mdion1/PCBA_power_supply/power supply enclosure rev 2/front panel cover countersunk holes.pptx

ø3.6mm holes must be countersunk to a depth of 1.2mm and a diameter of 5.7mm

Front view

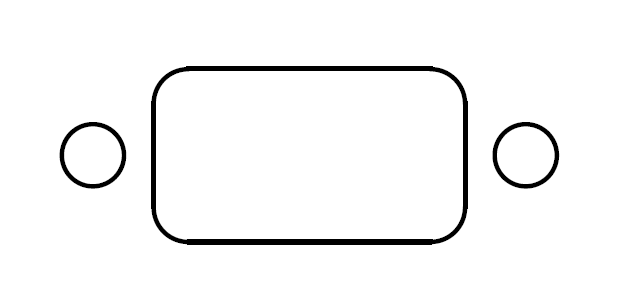
[picture p1: figure]

(Overall thickness measured to be ~2.8mm)

(Panel exterior face)

Side view of individual hole

1.2mm

ø5.7mm

ø3.6mm

(Panel interior face)
