mdion1/PCBA_power_supply/Rev1/Power supply BOM 2017_04_25.xlsx

Part ID | Qty | Notes | Value | Footprint | Vendor | Vendor PN
C1, 2, 3, 4 | 4 |  | 2200u, 35V | Thru-hole | Mouser | 667-EEU-FR1V222B | 4
C5 | 1 |  | 2.2u, 35V | SMT 0805 | Mouser | 81-GRM219C8YA225KE5D | 1
C6 | 1 |  | 22u, 10V | SMT 0805 | Mouser | 810-C2012JB1V226M12C | 1
C7, 9, 11, 13 | 4 |  | 10u, 35V | SMT 0805 | Mouser | 81-GRM21BR6YA106KE3L | 963-GMK212BBJ106KG-T alt
C8, 10, 12, 14 | 4 |  | 100n, 35V | SMT 0603 | Mouser | 963-GMK107BJ104KAHT | 4
J1 | 1 |  |  | Thru-hole | Mouser | 562-703W-00/54 | 1
J2 | 1 |  |  | Thru-hole | Mouser | 649-D09S33E4PA00LF | 1, missing "1" in name, also has another correct entry
L1, 2, 3, 4 | 4 |  |  | Thru-hole | Mouser | 983-T60006-L2016W403 | 4
R1 | 1 |  | 42.2k | SMT 0603 | Mouser | 71-TNPW060342K2BEEA | 1
R2 | 1 |  | 154k | SMT 0603 | Mouser | 667-ERA-3AEB1543V | 1
U1, 2 | 2 |  |  | Thru-hole | Mouser | 709-IRM30-24 | 2, backordered mouser
U3 | 1 |  |  | LGA-50 | Digikey | LTM8022EV#PBF-ND | 1
 |  |  |  |  |  | 963-GMK212BBJ106KG-T (http://www.mouser.com/Search/ProductDetail.aspx) | 4
 |  |  |  |  |  | IRM-30-24 from allied, backordered
