mdion1/PCBA_power_supply/Rev5 Kicad/BOM pwr supply rev 5 2019_09_04 abridged.xlsx

Designator | Mfr P/N
PS2,PS1 | TPP 30-115A-D
C1 | C1608JB1E225M080AB
C2,C3,C6,C7,C10,C11,C15,C16 | GMK107BJ105KAHT
C4,C5,C8,C9,C12,C13,C17,C18 | EEU-FR1V561
C14 | EMK212BBJ226MG-T
J2 | ID09S33E4GX00LF
R1 | ERA-3AEB4222V
R2 | ERA3AEB1543V
J1 | 703W-00/54
C19,C20,C21,C22,C23,C24,C25,C26 | 885012206089
U1 | LTM8022EV#PBF
L1,L2,L3,L4,L5,L6,L7,L8 | ASPI-6045S-100M-T
D1,D2 | TP1.5KE18A
