mdion1/PCBA_power_supply/Rev5 Kicad/BOM pwr supply rev 5 2019_09_04.xlsx

Designator | Package | Quantity | Designation | Supplier | Supplier P/N | Alternatives
PS2,PS1 | TPP 30-115A-D | 2 | TPP 30-115A-D | Mouser | 495-TPP30-115A-D |  | $35.63/e @ qty 25
C1 | C_0603 | 1 | 2.2u | Mouser | C1608JB1E225M080AB | C1608X5R1E225K080AE | $0.113/e @ qty 10
C2,C3,C6,C7,C10,C11,C15,C16 | C_0603 | 8 | 1u | Mouser | 963-GMK107BJ105KAHT | CL10A105KB8NNNC, GRT188R61H105ME13D | $0.104/e @ qty 100
C4,C5,C8,C9,C12,C13,C17,C18 | CP_Radial_D10.0mm_P5.00mm | 8 | 560u | Mouser | 667-EEU-FR1V561 | EEU-FS1V102LB ? | $0.373/e @ qty 100
C14 | C_0805 | 1 | 22u | Mouser | EMK212BBJ226MG-T | GRM219R61C226ME15K | $0.442/e @ qty 10
J2 | DB9FC | 1 | DB9_Female_MountingHoles | Mouser | 649-ID09S33E4GX00LF |  | $0.827/e @ qty 10
R1 | R_0603 | 1 | 42.2k | Mouser | ERA-3AEB4222V |  | $0.249/e @ qty 10
R2 | R_0603 | 1 | 154k | Mouser | 667-ERA-3AEB1543V |  | $0.249/e @ qty 10
J1 | AC_receptacle | 1 | Conn_WallPlug_Earth | Mouser | 562-703W-00/54 |  | $0.858/e @ qty 20
C19,C20,C21,C22,C23,C24,C25,C26 | C_0603 | 8 | 10n | Mouser | 710-885012206089 | GCM188R72A103KA37D | $0.054/e @ qty 100
U1 | LGA-50 | 1 | LTM8022 | Digikey | LTM8022EV#PBF-ND |  | $10.13/e @ qty 25
L1,L2,L3,L4,L5,L6,L7,L8 | 6045_inductor | 8 | 10u | Mouser | 815-ASPI-6045S-100MT |  | $0.468/e @ qty 50
D1,D2 | Thru-hole, vertical | 2 | 18v | Mouser | 576-TP1.5KE18A |  | $0.62/e @ qty 10
 |  | 43
