mdion1/PCBA_power_supply/power supply enclosure/lid.stl

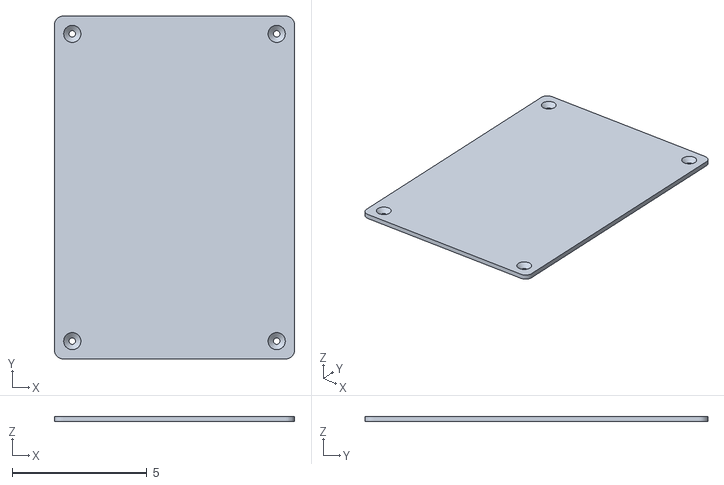
[picture p2: CAD file, 2021-01-22]
power supply enclosure/lid.stl
8.89 x 12.7 x 0.201
