mdion1/PCBA_power_supply/power supply enclosure/Bud enclosure CU389.stp

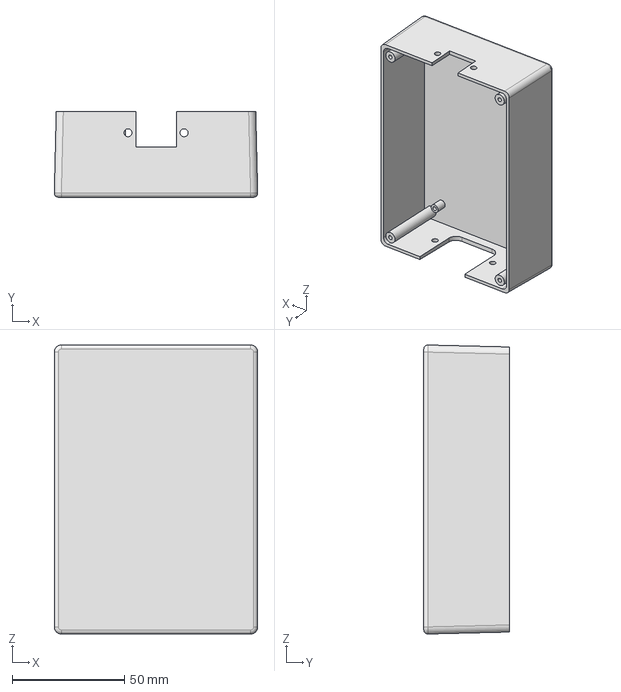
[picture p3: CAD file, 2021-01-22]
power supply enclosure/Bud enclosure CU389.stp
90.6 x 38.1 x 128.7 mm
