mdion1/PCBA_power_supply/(list of files, cad)

Other CAD files:
old revisions/power supply enclosure/AC entry module.ipt
old revisions/power supply enclosure/Assembly1.iam
old revisions/power supply enclosure/Bud enclosure CU389.idw
old revisions/power supply enclosure/Bud enclosure CU389.ipt
old revisions/power supply enclosure/Bud enclosure CU389.stl
old revisions/power supply enclosure/OldVersions/Assembly1.0006.iam
old revisions/power supply enclosure/OldVersions/Bud enclosure CU389.0004.idw
old revisions/power supply enclosure/OldVersions/Bud enclosure CU389.0008.ipt
old revisions/power supply enclosure/OldVersions/power supply pcb.0004.ipt
old revisions/power supply enclosure/lid.ipt
old revisions/power supply enclosure/power supply pcb.ipt
power supply enclosure rev 2/AC entry module.ipt
power supply enclosure rev 2/AC entry module.newVer.ipt
power supply enclosure rev 2/Assembly 2017_08_31.iam
power supply enclosure rev 2/DB9 connector 2017_06_14.ipt
power supply enclosure rev 2/Enclosure front and back faces.idw
power supply enclosure rev 2/OldVersions/Assembly 2017_06_14.0002.iam
power supply enclosure rev 2/OldVersions/Assembly 2017_08_23.0006.iam
power supply enclosure rev 2/OldVersions/Assembly 2017_08_31.0006.iam
power supply enclosure rev 2/OldVersions/Assembly1.0011.iam
power supply enclosure rev 2/OldVersions/Bigger slide switch 2017_06_14.0001.ipt
power supply enclosure rev 2/OldVersions/DB15 connector 2017_06_14.0001.ipt
power supply enclosure rev 2/OldVersions/DB15 connector.0001.ipt
power supply enclosure rev 2/OldVersions/DB9 connector 2017_06_14.0004.ipt
power supply enclosure rev 2/OldVersions/DB9 connector.0001.ipt
power supply enclosure rev 2/OldVersions/DB9 connector.0002.ipt
power supply enclosure rev 2/OldVersions/Enclosure front and back faces.0023.idw
power supply enclosure rev 2/OldVersions/Grounded banana jack.0001.ipt
power supply enclosure rev 2/OldVersions/PCB.0002.ipt
power supply enclosure rev 2/OldVersions/Slide switch.0002.ipt
power supply enclosure rev 2/OldVersions/USB A block.0003.ipt
power supply enclosure rev 2/OldVersions/back cover.0016.ipt
power supply enclosure rev 2/OldVersions/front cover.0019.ipt
power supply enclosure rev 2/On-off pushbutton.ipt
power supply enclosure rev 2/PCB.ipt
power supply enclosure rev 2/back cover.ipt
power supply enclosure rev 2/front cover.ipt
power supply enclosure/AC entry module.ipt
power supply enclosure/Assembly1.iam
power supply enclosure/Bud enclosure CU389.idw
power supply enclosure/Bud enclosure CU389.ipt
power supply enclosure/Bud enclosure CU389.stl
power supply enclosure/lid.ipt
power supply enclosure/power supply pcb.ipt
