mdion1/PCBA_power_supply/power supply enclosure rev 2/Power supply enclosure front and back faces 2017_9_29.pdf

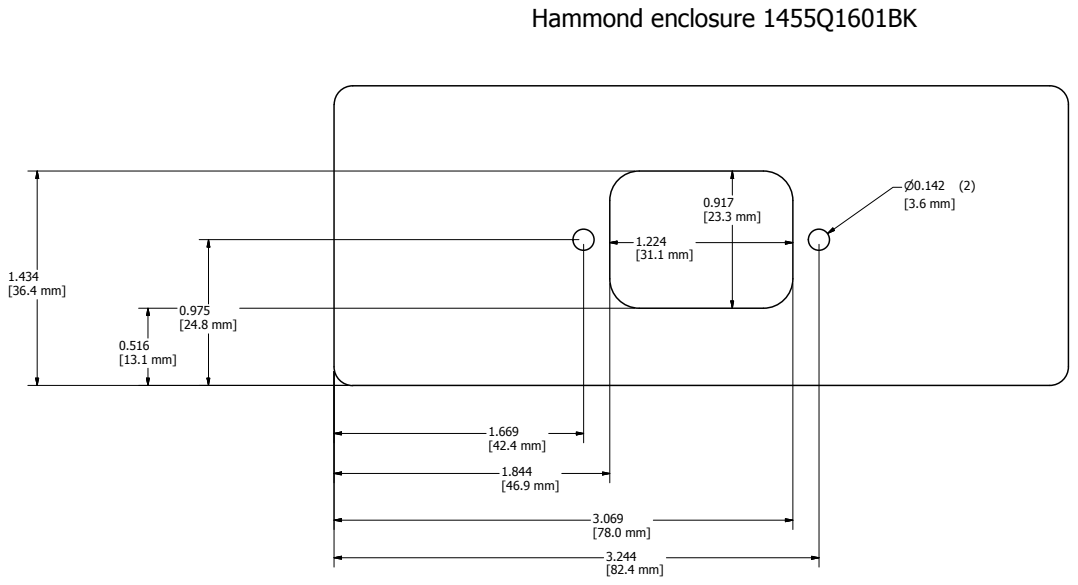
[picture p8: page 1]
SHEET 1 OF 2; DRAWN; CHECKED; MFG; APPROVED; Brandon; TITLE; SIZE C; SCALE; REV; Hammond enclosure 1455Q1601BK

DWG NO
Enclosure front and back faces

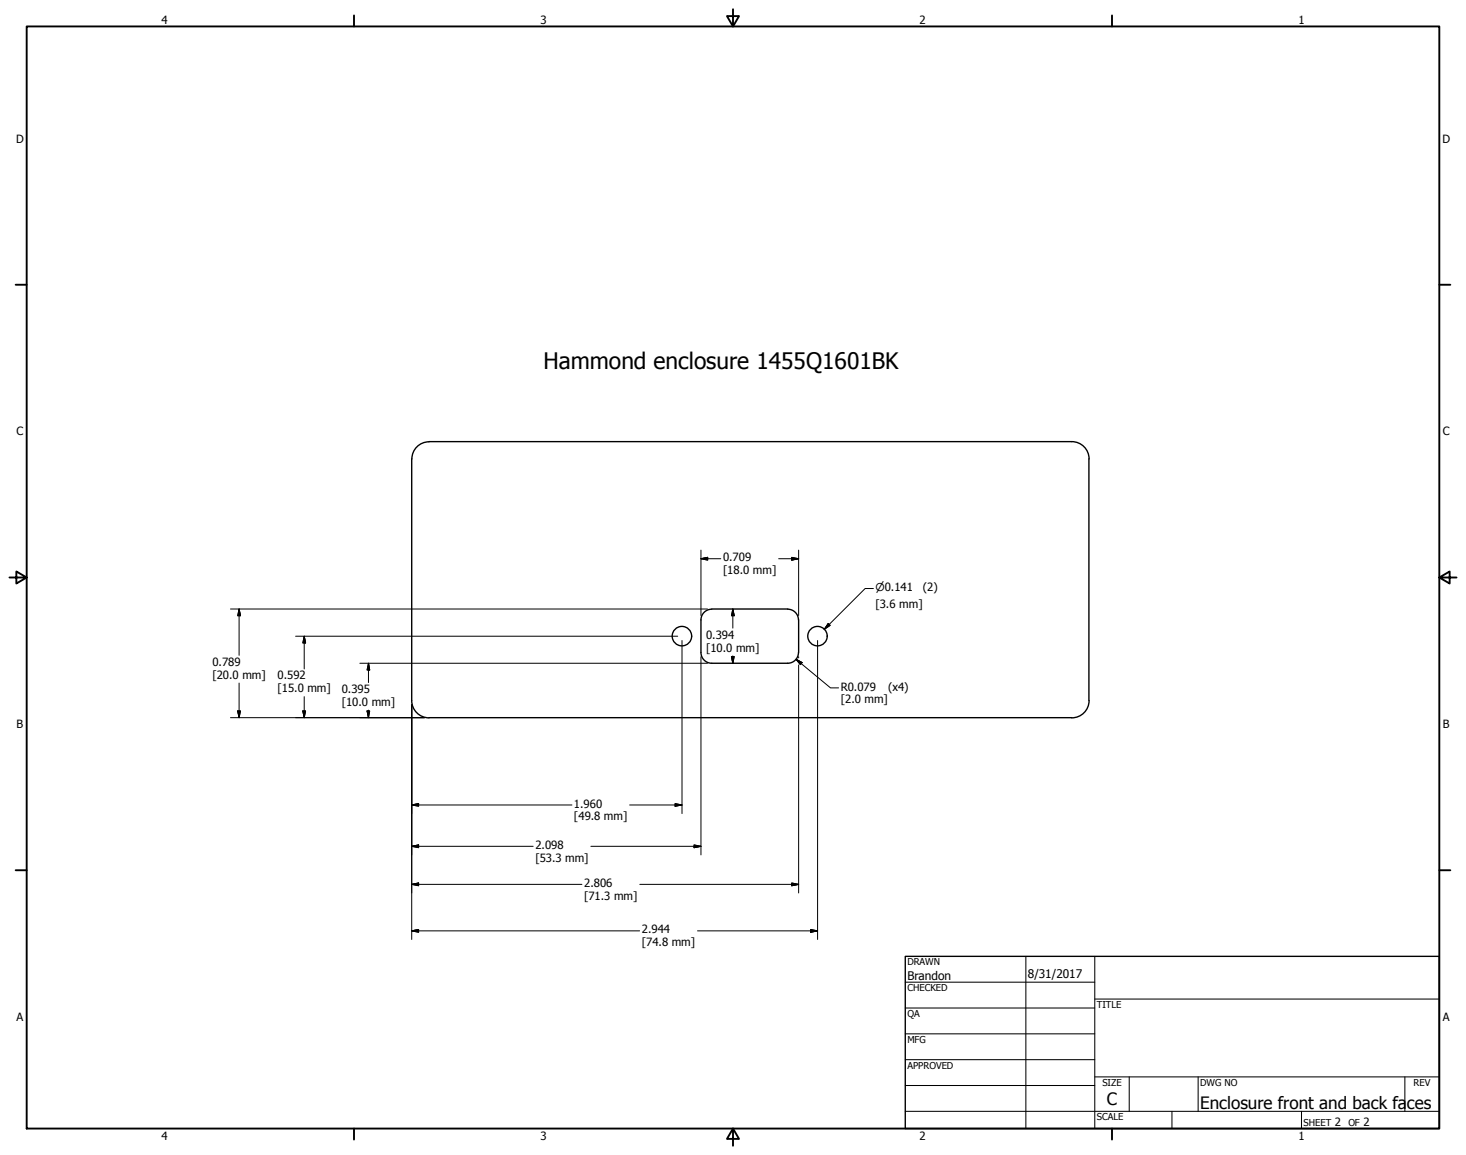
[picture p9: page 2]
SHEET 2 OF 2; DRAWN; CHECKED; MFG; APPROVED; Brandon; TITLE; SIZE C; SCALE; REV; Hammond enclosure 1455Q1601BK

DWG NO
Enclosure front and back faces
