mdion1/PCBA_power_supply/power supply enclosure/Bud enclosure CU389.pdf

# Bud plastic enclosure CU-389

# Front

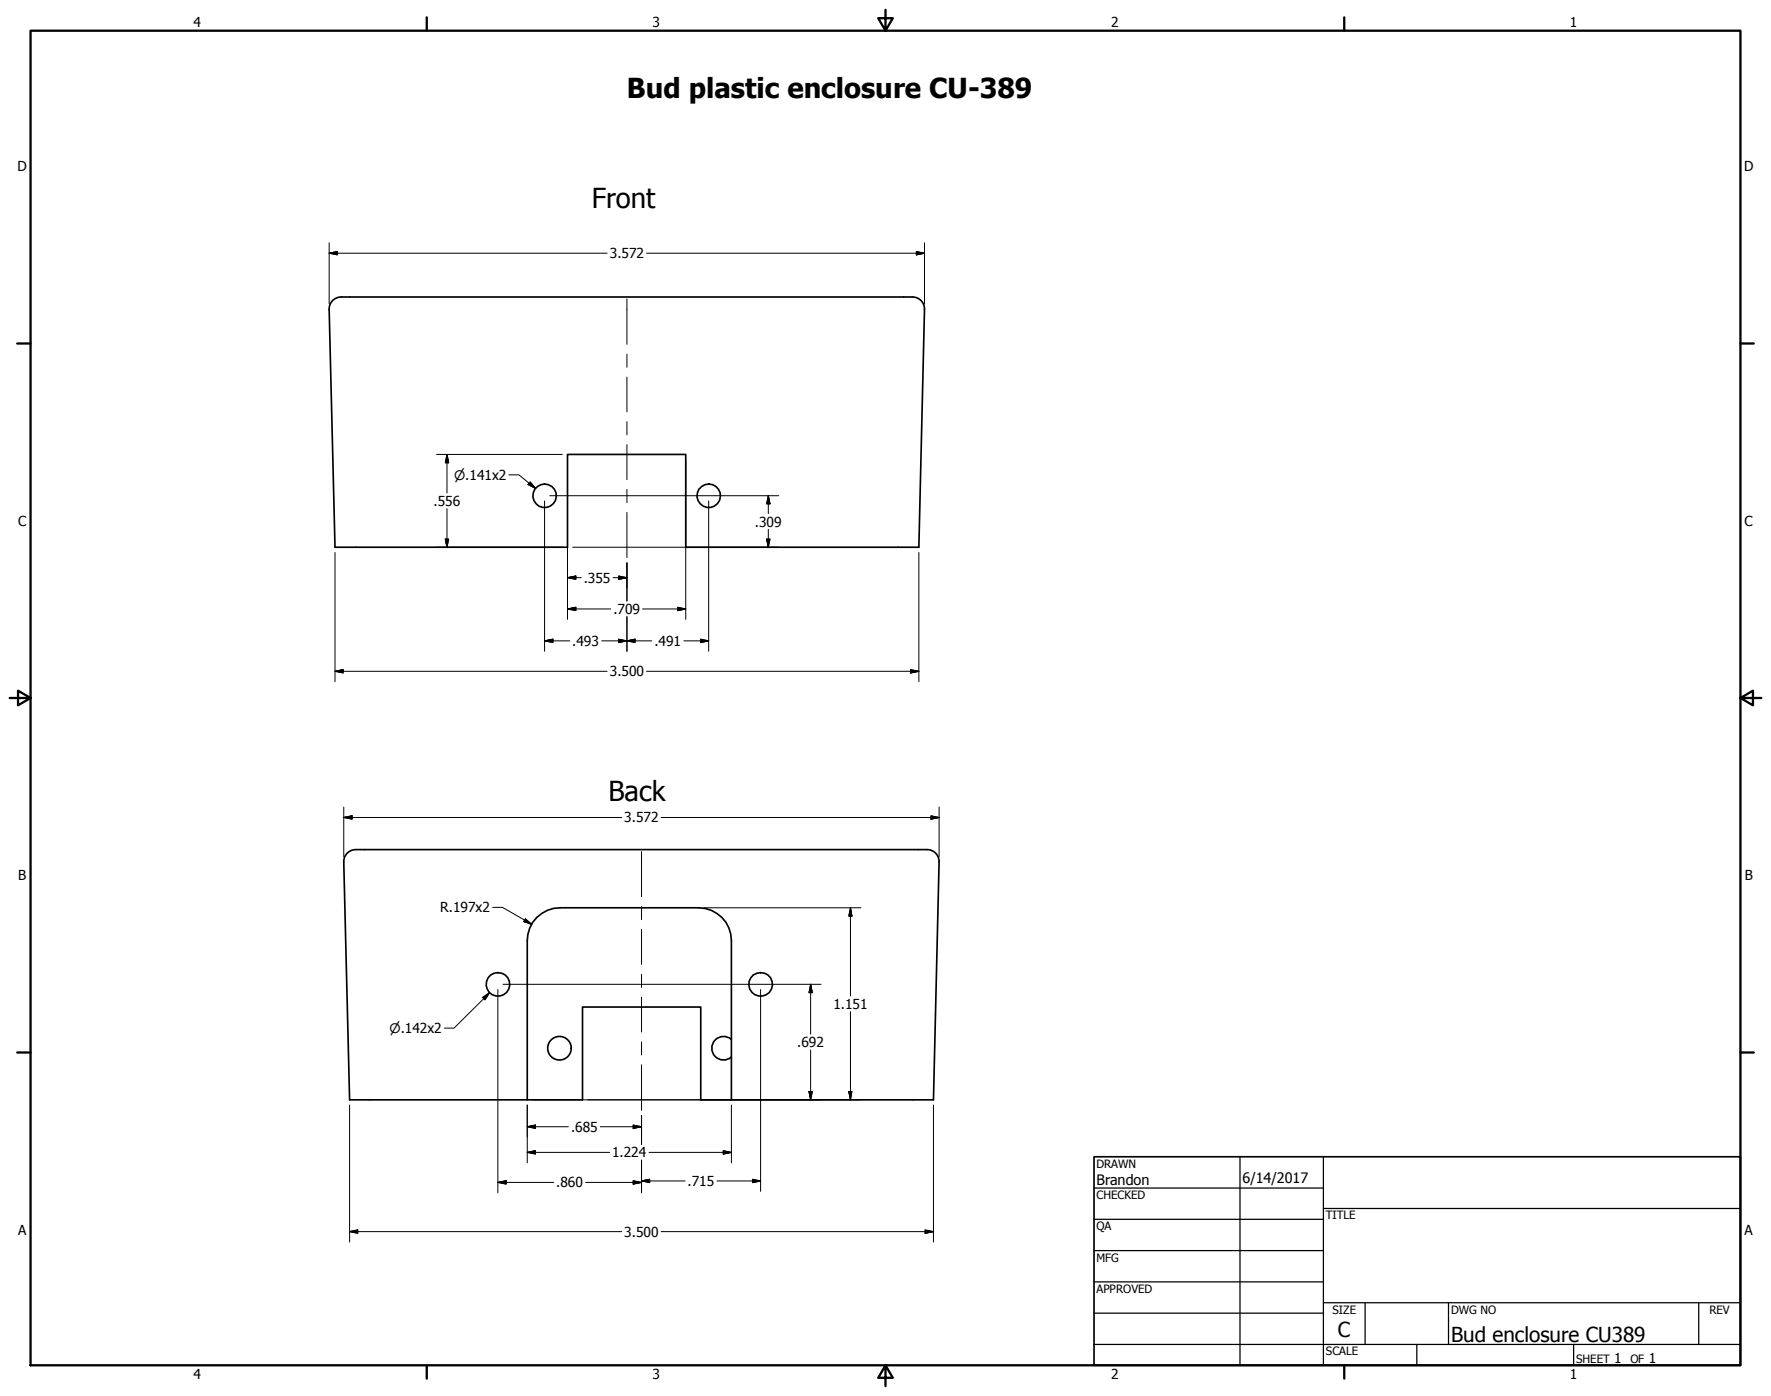
[picture p10: page 1]
SHEET 1 OF 1; DRAWN; CHECKED; MFG; APPROVED; Brandon; DWG NO Bud enclosure CU389; TITLE; SIZE C; SCALE; REV; Back
