mdion1/PCBA_power_supply/(list of files, drawings)

Other design files:
old revisions/Rev1/Power supply 2017_04_21 Dsub connectors.pcb
Rev1/Power supply 2017_04_21 Dsub connectors.pcb
