mdion1/PCBA_power_supply/old revisions/Rev5 Kicad/pwr supply rev 5.kicad_pcb

## KiCad design old revisions/Rev5 Kicad/pwr supply rev 5.kicad_pcb (2021-01-22, an earlier design)

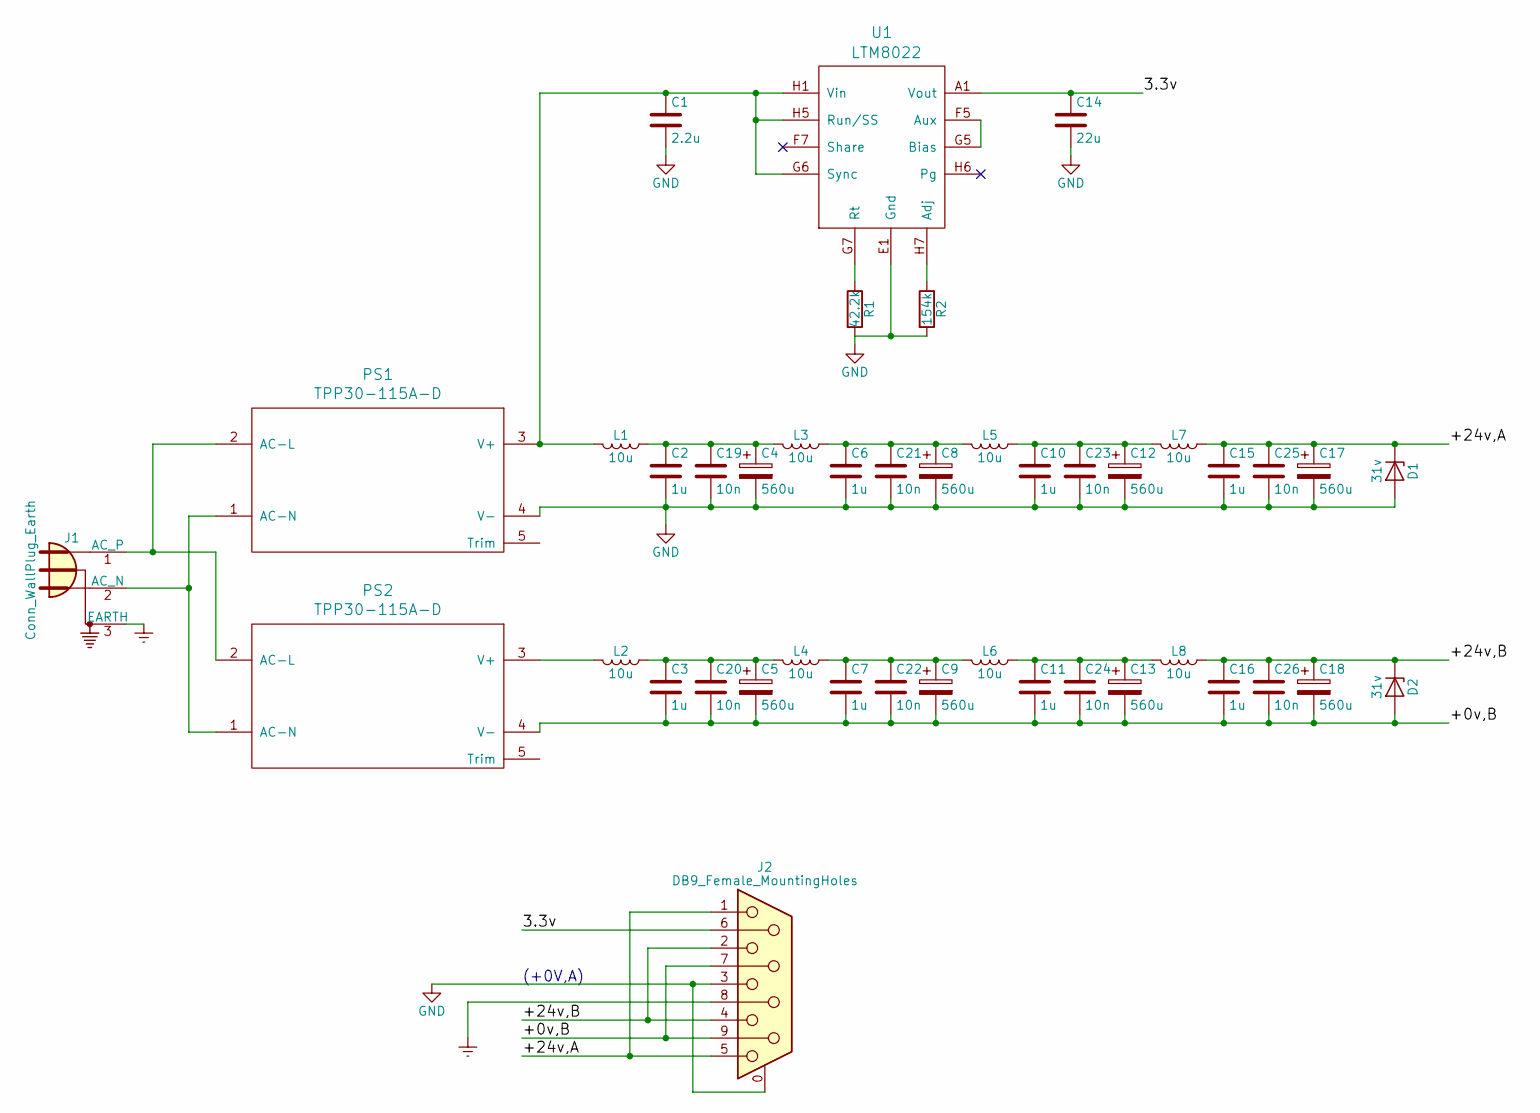
[picture p11: schematic pwr supply rev 5.sch]

Parts:
C1: 2.2u; C_0603
C2, C3, C6, C7, C10, C11, C15, C16: 1u; C_0603
C4, C5, C8, C9, C12, C13, C17, C18: 560u; CP_Radial_D10.0mm_P5.00mm
C14: 22u; C_0805
C19, C20, C21, C22, C23, C24, C25, C26: 10n; C_0603
D1, D2: 31v; D_DO-201_P5.08mm_Vertical_KathodeUp
J1: Conn_WallPlug_Earth; AC_receptacle
J2: DB9_Female_MountingHoles; DB9FC
L1, L2, L3, L4, L5, L6, L7, L8: 10u; 6045_inductor
PS1, PS2: TPP30-115A-D; TPP-30-115A-D
R1: 42.2k; R_0603
R2: 154k; R_0603
U1: LTM8022; LGA-50

Connections:
/3.3v: C14.1, J2.6, U1.A1 (Vout)
/+0v,B: C3.2, C5.2, C7.2, C9.2, C11.2, C13.2, C16.2, C18.2, C20.2, C22.2, C24.2, C26.2, D2.2 (A), J2.7, J2.9, PS2.4 (V-)
/+24v,A: C15.1, C17.1, C25.1, D1.1 (K), J2.1, J2.5, L7.1
/+24v,B: C16.1, C18.1, C26.1, D2.1 (K), J2.2, J2.4, L8.1
Earth: J1.3 (EARTH), J2.8
GND: C1.2, C2.2, C4.2, C6.2, C8.2, C10.2, C12.2, C14.2, C15.2, C17.2, C19.2, C21.2, C23.2, C25.2, D1.2 (A), J2.0 (PAD), J2.3, PS1.4 (V-), R1.2, R2.2, U1.E1 (Gnd)
unnamed: C1.1, L1.2, PS1.3 (V+), U1.G6 (Sync), U1.H1 (Vin), U1.H5 (Run/SS)
unnamed: C10.1, C12.1, C23.1, L5.1, L7.2
unnamed: C11.1, C13.1, C24.1, L6.1, L8.2
unnamed: C2.1, C4.1, C19.1, L1.1, L3.2
unnamed: C3.1, C5.1, C20.1, L2.1, L4.2
unnamed: C6.1, C8.1, C21.1, L3.1, L5.2
unnamed: C7.1, C9.1, C22.1, L4.1, L6.2
unnamed: J1.1 (AC_P), PS1.2 (AC-L), PS2.2 (AC-L)
unnamed: J1.2 (AC_N), PS1.1 (AC-N), PS2.1 (AC-N)
unnamed: L2.2, PS2.3 (V+)
unnamed: R1.1, U1.G7 (Rt)
unnamed: R2.1, U1.H7 (Adj)
unnamed: U1.F5 (Aux), U1.G5 (Bias)

Notes on the sheet:
(+0V,A)

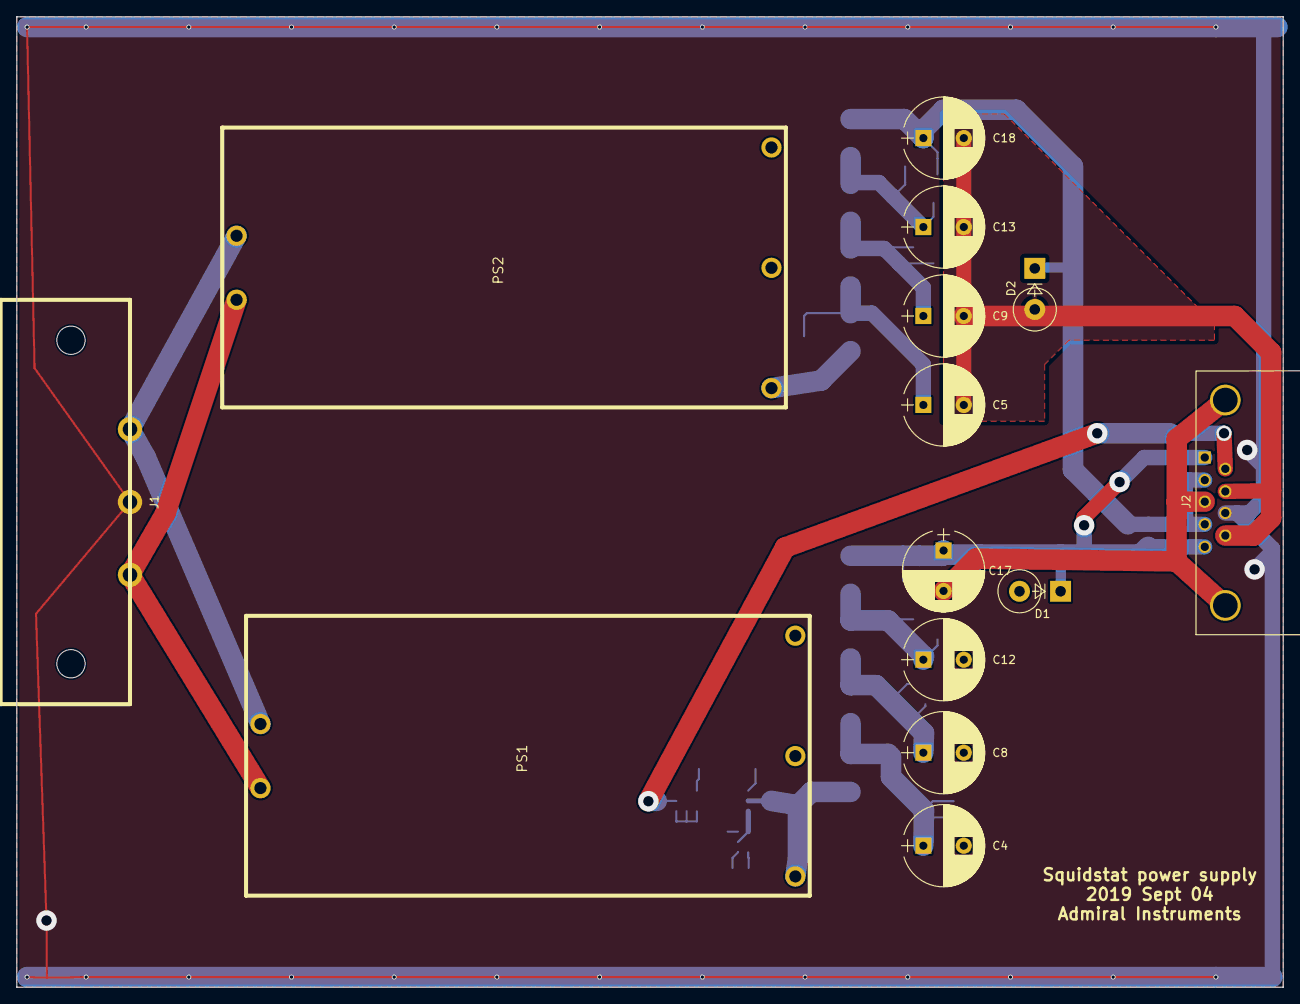
[picture p12: board pwr supply rev 5.kicad_pcb from above]

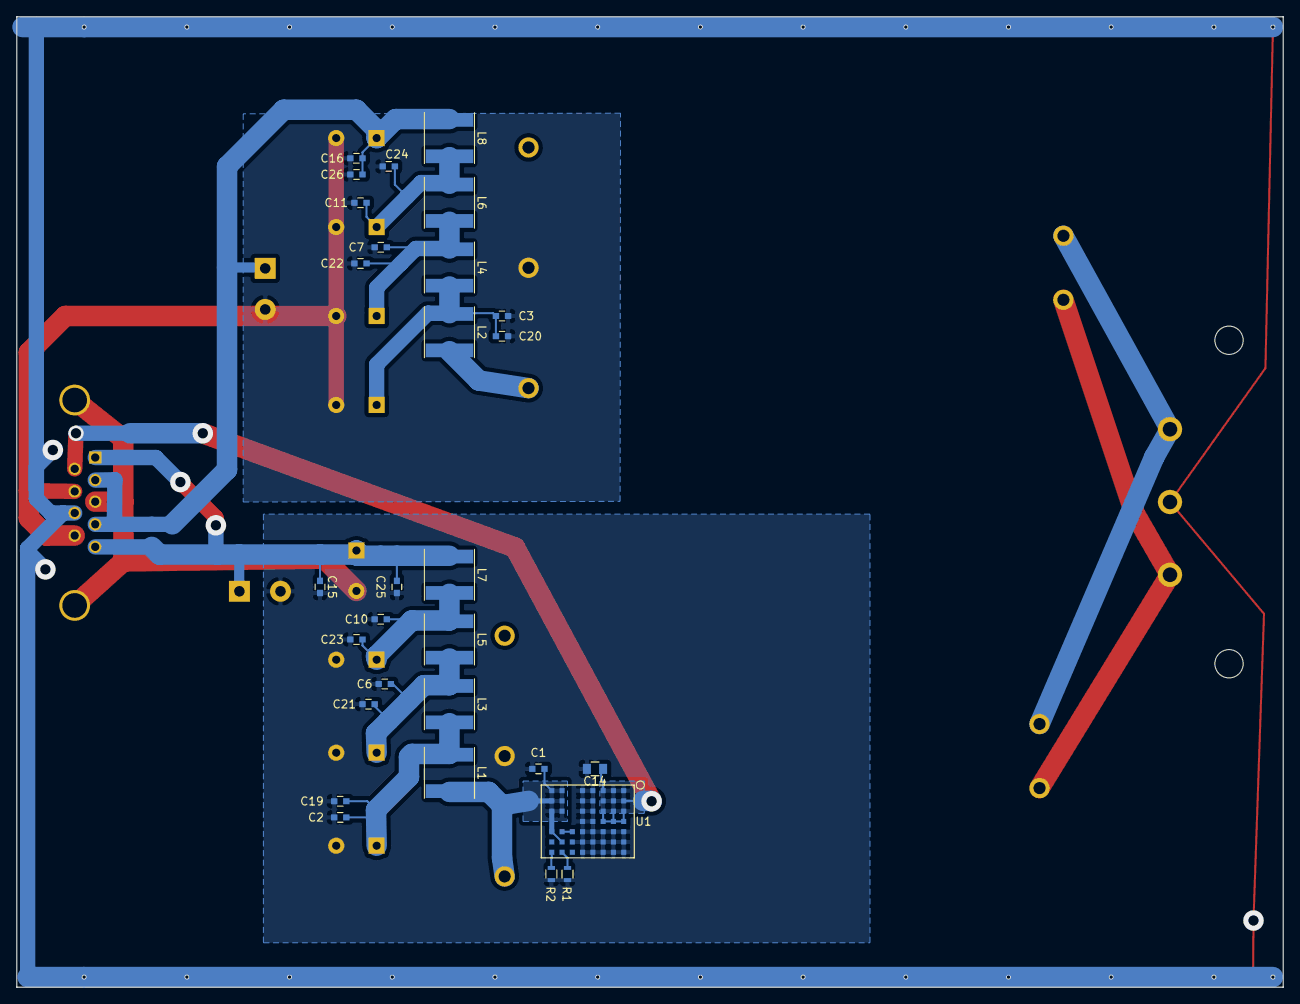
[picture p13: board pwr supply rev 5.kicad_pcb from below]

Board: 2 copper layers, 156.6 x 120.0 mm, 43 parts (29 on the bottom side), 19 nets.
