mdion1/PCBA_power_supply/Rev5 Kicad/rescue-backup/pwr supply rev 3-2019-01-03-11-25-52.sch

## KiCad design Rev5 Kicad/rescue-backup/pwr supply rev 3-2019-01-03-11-25-52.sch (2021-01-22)

Schematic: pwr supply rev 3-2019-01-03-11-25-52.sch

Parts:
C1: 2.2u; C_0603
C2, C3, C6, C7, C10, C11, C15, C16: 1u; C_0603
C4, C5, C8, C9, C12, C13, C17, C18: 560u; CP_Radial_D10.0mm_P5.00mm
C14: 22u; C_0805
C19, C20, C21, C22, C23, C24, C25, C26: 10n; C_0603
D1, D2: 31v; PowerDI5
J1: Conn_WallPlug_Earth; AC_receptacle
J2: DB9_Female_MountingHoles; DB9FC
L1, L2, L3, L4, L5, L6, L7, L8: 10u; 6045_inductor
PS1, PS2: IRM-6024; IRM-60-24
R1: 42.2k; R_0603
R2: 154k; R_0603
U1: LTM8022; LGA-50

Notes on the sheet:
(+0V,A)
