mdion1/PCBA_power_supply/(commit log)

2021-01-22 Initial commit with previous versions
    [AC entry module.0001.ipt, AC entry module.ipt, AC entry module.newVer.ipt, Assembly 2017_06_14.0002.iam, Assembly 2017_08_23.0006.iam, Assembly 2017_08_31.0006.iam, Assembly 2017_08_31.iam, Assembly1.0006.iam]
2021-01-22 Slight modification to rev 5, added cap from local to earth gnd, adjustment pots, silkscreen changes
    [AC entry module.ipt, Assembly1.0006.iam, Assembly1.iam, BOM pwr supply rev 2 2017_08_30.xlsx, BOM pwr supply rev 3 2017_08_06.xlsx, BOM pwr supply rev 5 2019_09_04 abridged.xlsx, BOM pwr supply rev 5 2019_09_04.xlsx, BOM_PowerSupplyRev5_ 2019_09_04.xlsx]
